jahm86/MQTT_Router_Board/README.md

# MQTT_Router_Board
Tarjeta electrónica para proyecto didáctico de router MQTT

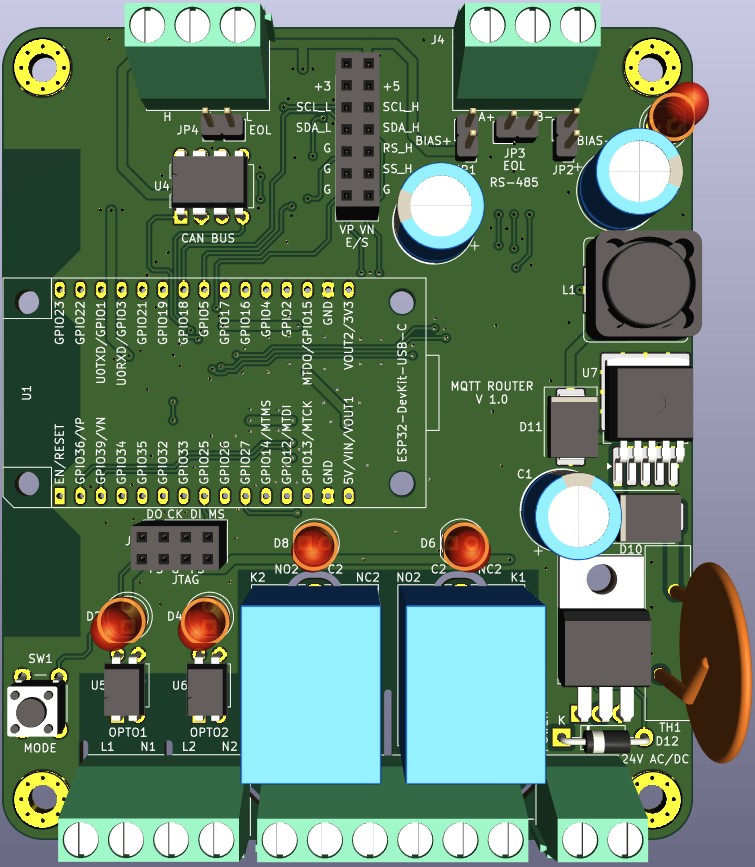
[picture p1: imagenes/MQTT_ROUTER_3D_F.jpg]
PCB de tarjeta electrónica, vista superior.

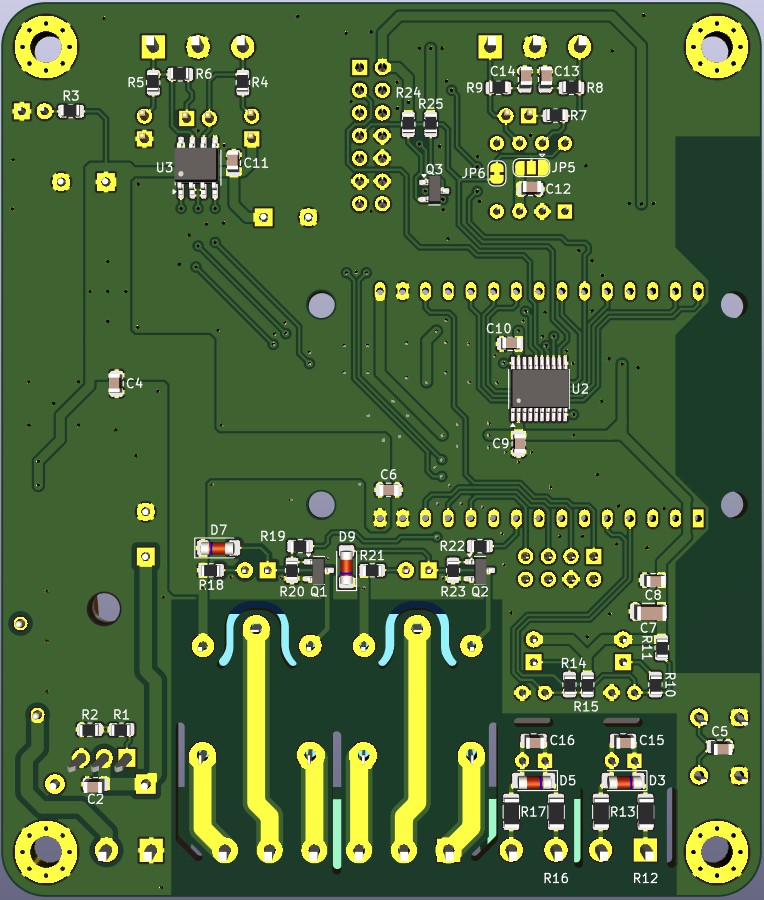
[picture p2: imagenes/MQTT_ROUTER_3D_B.jpg]
PCB de tarjeta electrónica, vista inferior.
