jahm86/MQTT_Router_Board/MQTT_ROUTER.kicad_pcb

## KiCad design MQTT_ROUTER.kicad_pcb (2026-02-03)

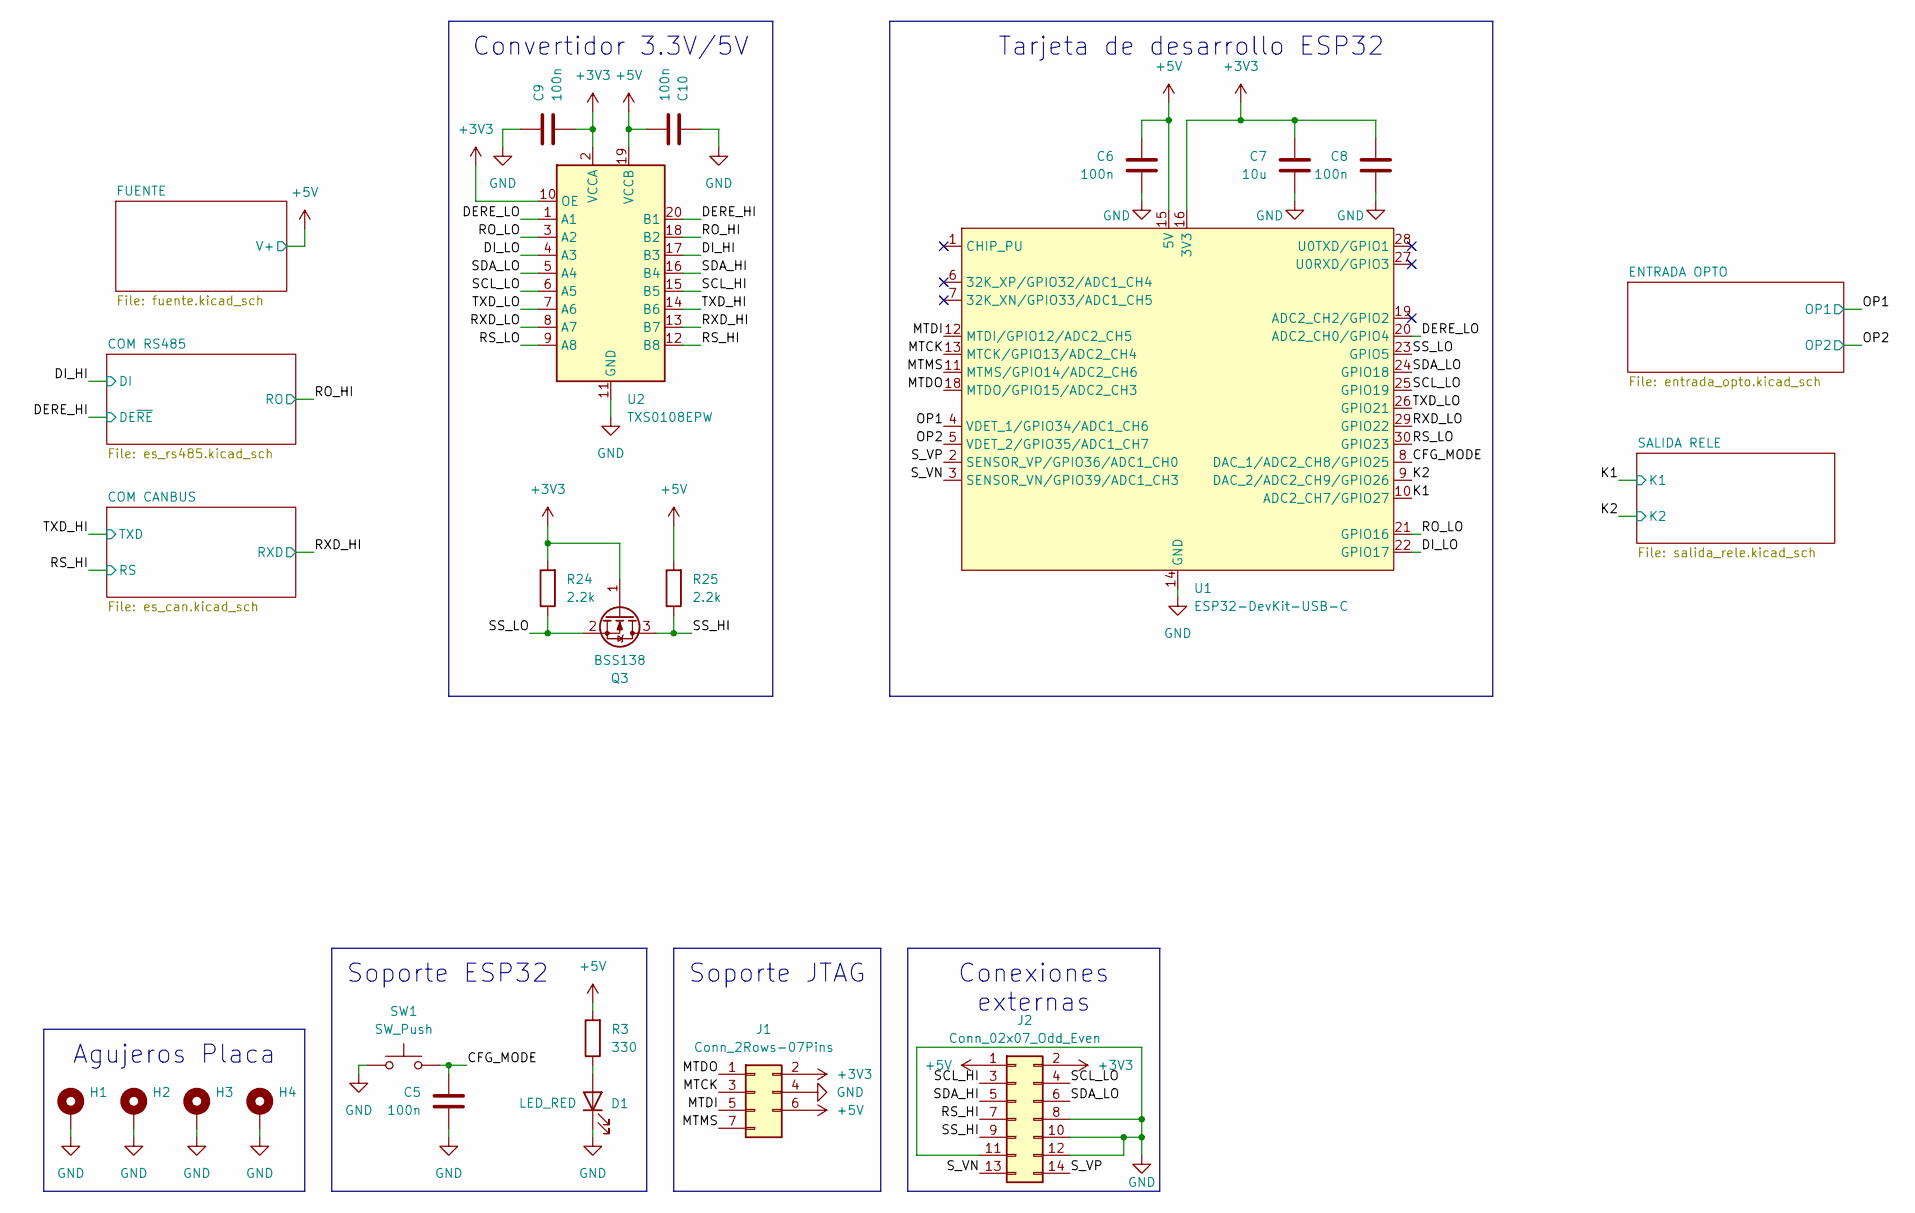
[picture p3: schematic MQTT_ROUTER.kicad_sch]

Parts:
C5, C6, C8, C9, C10: 100n; C_0805_2012Metric
C7: 10u; C_1206_3216Metric
D1: LED_RED; LED_D5.0mm
H1, H2, H3, H4: MountingHole_Pad; MountingHole_3.5mm_Pad_Via
J1: Conn_2Rows-07Pins; PinSocket_2x04_P2.54mm_Vertical
J2: Conn_02x07_Odd_Even; PinSocket_2x07_P2.54mm_Vertical
Q3: BSS138; SOT-23
R3: 330; R_0805_2012Metric
R24, R25: 2.2k; R_0805_2012Metric
SW1: SW_Push; SW_PUSH_6mm
U1: ESP32-DevKit-USB-C
U2: TXS0108EPW; TSSOP-20_4.4x6.5mm_P0.65mm

Connections:
+3V3: C7.1, C8.1, C9.2, J1.2, J2.2, Q3.1 (G), R24.2, U1.16 (3V3), U2.2 (VCCA), U2.10 (OE); also elsewhere on the board
+5V: C6.1, C10.2, J1.6, J2.1, R3.2, R25.2, U1.15 (5V), U2.19 (VCCB); also elsewhere on the board
/CFG_MODE: C5.1, SW1.2, U1.8 (DAC_1/ADC2_CH8/GPIO25)
/DERE_HI: U2.20 (B1); also elsewhere on the board
/DERE_LO: U1.20 (ADC2_CH0/GPIO4), U2.1 (A1)
/DI_HI: U2.17 (B3); also elsewhere on the board
/DI_LO: U1.22 (GPIO17), U2.4 (A3)
/K1: U1.10 (ADC2_CH7/GPIO27); also elsewhere on the board
/K2: U1.9 (DAC_2/ADC2_CH9/GPIO26); also elsewhere on the board
/MTCK: J1.3, U1.13 (MTCK/GPIO13/ADC2_CH4)
/MTDI: J1.5, U1.12 (MTDI/GPIO12/ADC2_CH5)
/MTDO: J1.1, U1.18 (MTDO/GPIO15/ADC2_CH3)
/MTMS: J1.7, U1.11 (MTMS/GPIO14/ADC2_CH6)
/OP1: U1.4 (VDET_1/GPIO34/ADC1_CH6); also elsewhere on the board
/OP2: U1.5 (VDET_2/GPIO35/ADC1_CH7); also elsewhere on the board
/RO_HI: U2.18 (B2); also elsewhere on the board
/RO_LO: U1.21 (GPIO16), U2.3 (A2)
/RS_HI: J2.7, U2.12 (B8); also elsewhere on the board
/RS_LO: U1.30 (GPIO23), U2.9 (A8)
/RXD_HI: U2.13 (B7); also elsewhere on the board
/RXD_LO: U1.29 (GPIO22), U2.8 (A7)
/SCL_HI: J2.3, U2.15 (B5)
/SCL_LO: J2.4, U1.25 (GPIO19), U2.6 (A5)
/SDA_HI: J2.5, U2.16 (B4)
/SDA_LO: J2.6, U1.24 (GPIO18), U2.5 (A4)
/SS_HI: J2.9, Q3.3 (D), R25.1
/SS_LO: Q3.2 (S), R24.1, U1.23 (GPIO5)
/S_VN: J2.13, U1.3 (SENSOR_VN/GPIO39/ADC1_CH3)
/S_VP: J2.14, U1.2 (SENSOR_VP/GPIO36/ADC1_CH0)
/TXD_HI: U2.14 (B6); also elsewhere on the board
/TXD_LO: U1.26 (GPIO21), U2.7 (A6)
GND: C5.2, C6.2, C7.2, C8.2, C9.1, C10.1, D1.1 (K), H1.1, H2.1, H3.1, H4.1, J1.4, J2.8, J2.10, J2.11, J2.12, SW1.1, U1.14 (GND), U1.17 (GND), U2.11 (GND); also elsewhere on the board
unnamed: D1.2 (A), R3.1

Notes on the sheet:
Soporte ESP32
Agujeros Placa
Convertidor 3.3V/5V
Tarjeta de desarrollo ESP32
Soporte JTAG
Conexiones externas

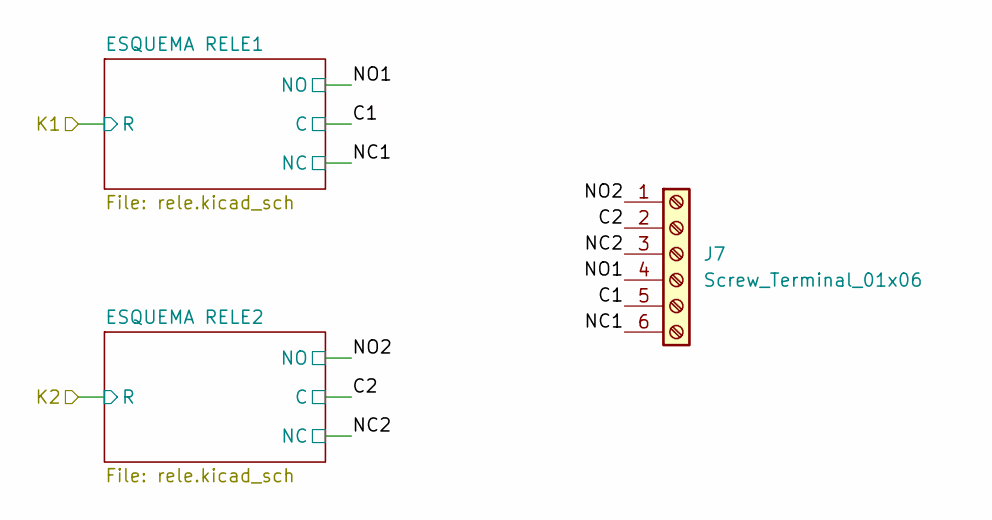
[picture p4: schematic salida_rele.kicad_sch]

Parts:
J7: Screw_Terminal_01x06; TerminalBlock_Phoenix_MKDS-1,5-6_1x06_P5.00mm_Horizontal

Connections:
/SALIDA RELE/C1: J7.5; also elsewhere on the board
/SALIDA RELE/C2: J7.2; also elsewhere on the board
/SALIDA RELE/NC1: J7.6; also elsewhere on the board
/SALIDA RELE/NC2: J7.3; also elsewhere on the board
/SALIDA RELE/NO1: J7.4; also elsewhere on the board
/SALIDA RELE/NO2: J7.1; also elsewhere on the board

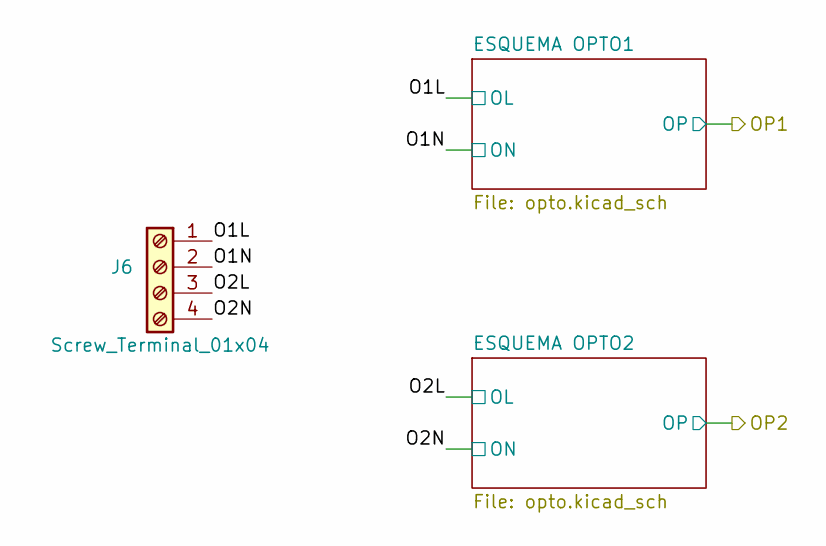
[picture p5: schematic entrada_opto.kicad_sch]

Parts:
J6: Screw_Terminal_01x04; TerminalBlock_Phoenix_MKDS-1,5-4_1x04_P5.00mm_Horizontal

Connections:
/ENTRADA OPTO/O1L: J6.1; also elsewhere on the board
/ENTRADA OPTO/O1N: J6.2; also elsewhere on the board
/ENTRADA OPTO/O2L: J6.3; also elsewhere on the board
/ENTRADA OPTO/O2N: J6.4; also elsewhere on the board

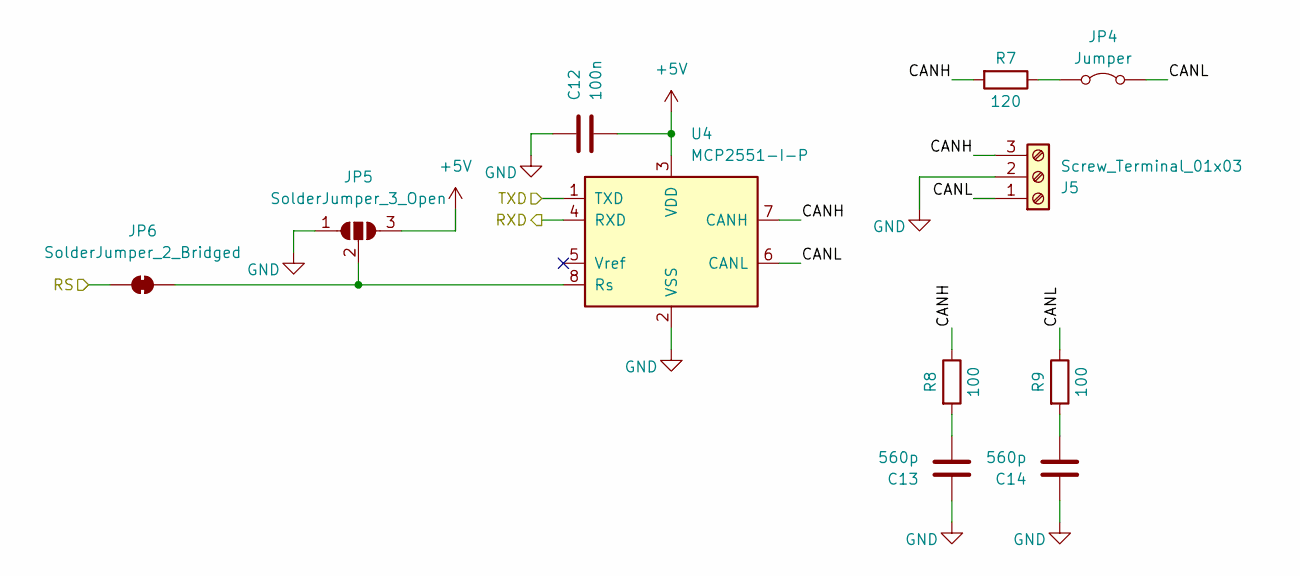
[picture p6: schematic es_can.kicad_sch]

Parts:
C12: 100n; C_0805_2012Metric
C13, C14: 560p; C_0805_2012Metric
J5: Screw_Terminal_01x03; TerminalBlock_Phoenix_MKDS-1,5-3_1x03_P5.00mm_Horizontal
JP4: Jumper; PinHeader_1x02_P2.54mm_Vertical
JP5: SolderJumper_3_Open; SolderJumper-3_P1.3mm_Open_RoundedPad1.0x1.5mm
JP6: SolderJumper_2_Bridged; SolderJumper-2_P1.3mm_Bridged_RoundedPad1.0x1.5mm
R7: 120; R_0805_2012Metric
R8, R9: 100; R_0805_2012Metric
U4: MCP2551-I-P; DIP-8_W7.62mm

Connections:
+5V: C12.2, JP5.3 (B), U4.3 (VDD); also elsewhere on the board
/COM CANBUS/CANH: J5.3, R7.2, R8.1, U4.7 (CANH)
/COM CANBUS/CANL: J5.1, JP4.2 (B), R9.1, U4.6 (CANL)
/RS_HI: JP6.1 (A); also elsewhere on the board
/RXD_HI: U4.4 (RXD); also elsewhere on the board
/TXD_HI: U4.1 (TXD); also elsewhere on the board
GND: C12.1, C13.1, C14.1, J5.2, JP5.1 (A), U4.2 (VSS); also elsewhere on the board
unnamed: C13.2, R8.2
unnamed: C14.2, R9.2
unnamed: JP4.1 (A), R7.1
unnamed: JP5.2 (C), JP6.2 (B), U4.8 (Rs)

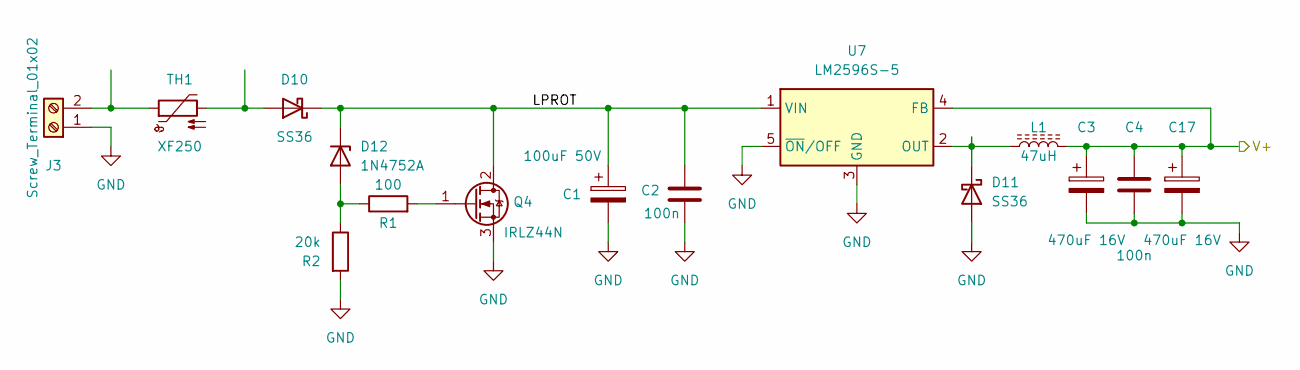
[picture p7: schematic fuente.kicad_sch]

Parts:
C1: 100uF 50V; CP_Radial_D10.0mm_P5.00mm
C2, C4: 100n; C_0805_2012Metric
C3, C17: 470uF 16V; CP_Radial_D10.0mm_P5.00mm
D10, D11: SS36; D_SMC
D12: 1N4752A; D_DO-41_SOD81_P10.16mm_Horizontal
J3: Screw_Terminal_01x02; TerminalBlock_Phoenix_MKDS-1,5-2_1x02_P5.00mm_Horizontal
L1: 47uH; L_Bourns_SRR1260
Q4: IRLZ44N; TO-220-3_Horizontal_TabDown
R1: 100; R_0805_2012Metric
R2: 20k; R_0805_2012Metric
TH1: XF250; Fuse_BelFuse_0ZRE0125FF_L21.2mm_W5.3mm
U7: LM2596S-5; TO-263-5_TabPin3

Connections:
+5V: C3.1, C4.1, C17.1, L1.2, U7.4 (FB); also elsewhere on the board
/FUENTE/LPROT: C1.1, C2.1, D10.1 (K), D12.1 (K), Q4.2 (D), U7.1 (VIN)
GND: C1.2, C2.2, C3.2, C4.2, C17.2, D11.2 (A), J3.1, Q4.3 (S), R2.2, U7.3 (GND), U7.5 (~ON/OFF); also elsewhere on the board
unnamed: D10.2 (A), TH1.2
unnamed: D11.1 (K), L1.1, U7.2 (OUT)
unnamed: D12.2 (A), R1.1, R2.1
unnamed: J3.2, TH1.1
unnamed: Q4.1 (G), R1.2

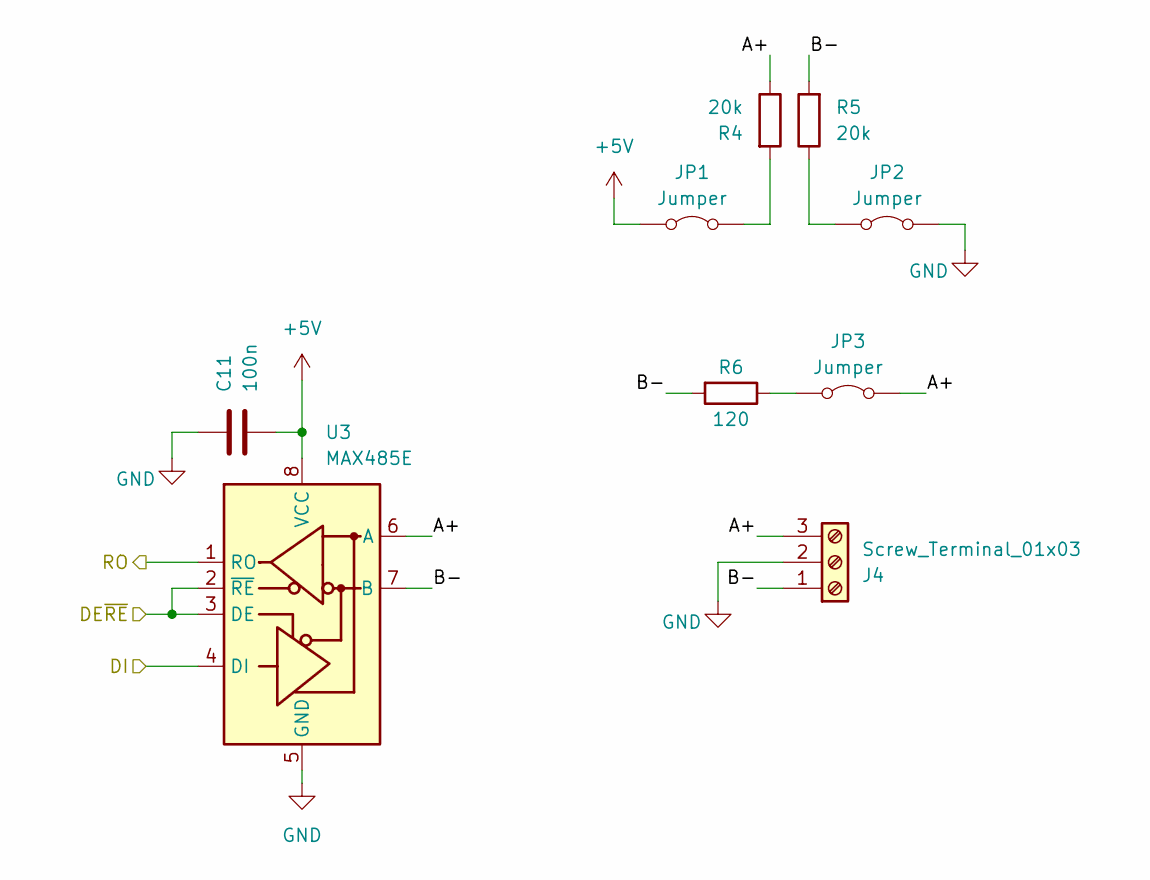
[picture p8: schematic es_rs485.kicad_sch]

Parts:
C11: 100n; C_0805_2012Metric
J4: Screw_Terminal_01x03; TerminalBlock_Phoenix_MKDS-1,5-3_1x03_P5.00mm_Horizontal
JP1, JP2, JP3: Jumper; PinHeader_1x02_P2.54mm_Vertical
R4, R5: 20k; R_0805_2012Metric
R6: 120; R_0805_2012Metric
U3: MAX485E; SOIC-8_3.9x4.9mm_P1.27mm

Connections:
+5V: C11.2, JP1.1 (A), U3.8 (VCC); also elsewhere on the board
/COM RS485/A+: J4.3, JP3.2 (B), R4.1, U3.6 (A)
/COM RS485/B-: J4.1, R5.2, R6.2, U3.7 (B)
/DERE_HI: U3.2 (~RE), U3.3 (DE); also elsewhere on the board
/DI_HI: U3.4 (DI); also elsewhere on the board
/RO_HI: U3.1 (RO); also elsewhere on the board
GND: C11.1, J4.2, JP2.1 (A), U3.5 (GND); also elsewhere on the board
unnamed: JP1.2 (B), R4.2
unnamed: JP2.2 (B), R5.1
unnamed: JP3.1 (A), R6.1

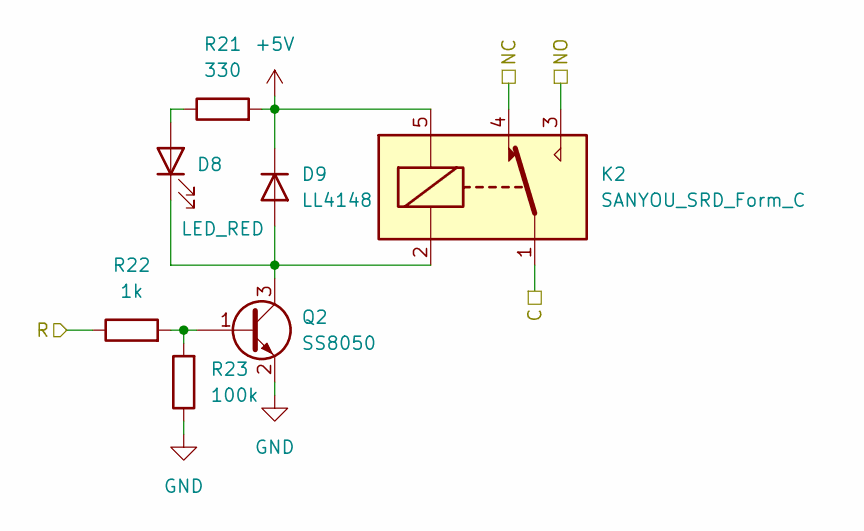
[picture p9: schematic rele.kicad_sch]

Parts:
D8: LED_RED; LED_D5.0mm
D9: LL4148; D_MiniMELF
K2: SANYOU_SRD_Form_C; Relay_SPDT_SANYOU_SRD_Series_Form_C
Q2: SS8050; SOT-23
R21: 330; R_0805_2012Metric
R22: 1k; R_0805_2012Metric
R23: 100k; R_0805_2012Metric

Connections:
+5V: D9.1 (K), K2.5, R21.2; also elsewhere on the board
/K2: R22.1; also elsewhere on the board
/SALIDA RELE/C2: K2.1; also elsewhere on the board
/SALIDA RELE/NC2: K2.4; also elsewhere on the board
/SALIDA RELE/NO2: K2.3; also elsewhere on the board
GND: Q2.2 (E), R23.1; also elsewhere on the board
unnamed: D8.2 (A), R21.1
unnamed: D8.1 (K), D9.2 (A), K2.2, Q2.3 (C)
unnamed: Q2.1 (B), R22.2, R23.2

Parts of its further copies:
D6: LED_RED; LED_D5.0mm
D7: LL4148; D_MiniMELF
K1: SANYOU_SRD_Form_C; Relay_SPDT_SANYOU_SRD_Series_Form_C
Q1: SS8050; SOT-23
R18: 330; R_0805_2012Metric
R19: 1k; R_0805_2012Metric
R20: 100k; R_0805_2012Metric

Connections of its further copies:
+5V: D7.1 (K), K1.5, R18.2; also elsewhere on the board
/K1: R19.1; also elsewhere on the board
/SALIDA RELE/C1: K1.1; also elsewhere on the board
/SALIDA RELE/NC1: K1.4; also elsewhere on the board
/SALIDA RELE/NO1: K1.3; also elsewhere on the board
GND: Q1.2 (E), R20.1; also elsewhere on the board
unnamed: D6.2 (A), R18.1
unnamed: D6.1 (K), D7.2 (A), K1.2, Q1.3 (C)
unnamed: Q1.1 (B), R19.2, R20.2

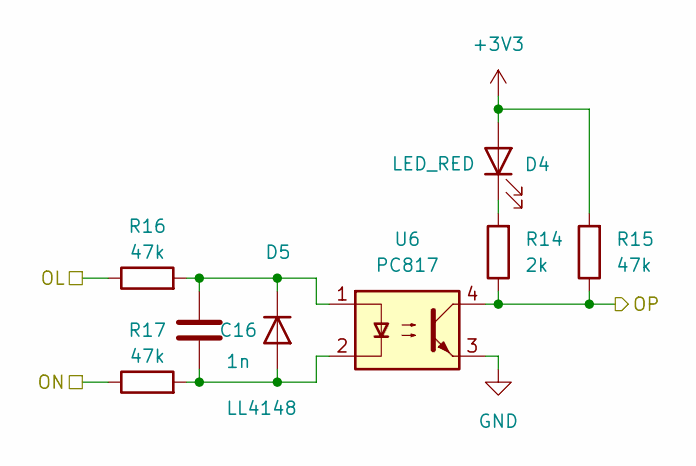
[picture p10: schematic opto.kicad_sch]

Parts:
C16: 1n; C_0805_2012Metric
D4: LED_RED; LED_D5.0mm
D5: LL4148; D_MiniMELF
R14: 2k; R_0805_2012Metric
R15: 47k; R_0805_2012Metric
R16, R17: 47k; R_1206_3216Metric
U6: PC817; DIP-4_W7.62mm

Connections:
+3V3: D4.2 (A), R15.2; also elsewhere on the board
/ENTRADA OPTO/O2L: R16.1; also elsewhere on the board
/ENTRADA OPTO/O2N: R17.1; also elsewhere on the board
/OP2: R14.1, R15.1, U6.4; also elsewhere on the board
GND: U6.3; also elsewhere on the board
unnamed: D4.1 (K), R14.2
unnamed: C16.2, D5.2 (A), R17.2, U6.2
unnamed: C16.1, D5.1 (K), R16.2, U6.1

Parts of its further copies:
C15: 1n; C_0805_2012Metric
D2: LED_RED; LED_D5.0mm
D3: LL4148; D_MiniMELF
R10: 2k; R_0805_2012Metric
R11: 47k; R_0805_2012Metric
R12, R13: 47k; R_1206_3216Metric
U5: PC817; DIP-4_W7.62mm

Connections of its further copies:
+3V3: D2.2 (A), R11.2; also elsewhere on the board
/ENTRADA OPTO/O1L: R12.1; also elsewhere on the board
/ENTRADA OPTO/O1N: R13.1; also elsewhere on the board
/OP1: R10.1, R11.1, U5.4; also elsewhere on the board
GND: U5.3; also elsewhere on the board
unnamed: D2.1 (K), R10.2
unnamed: C15.2, D3.2 (A), R13.2, U5.2
unnamed: C15.1, D3.1 (K), R12.2, U5.1

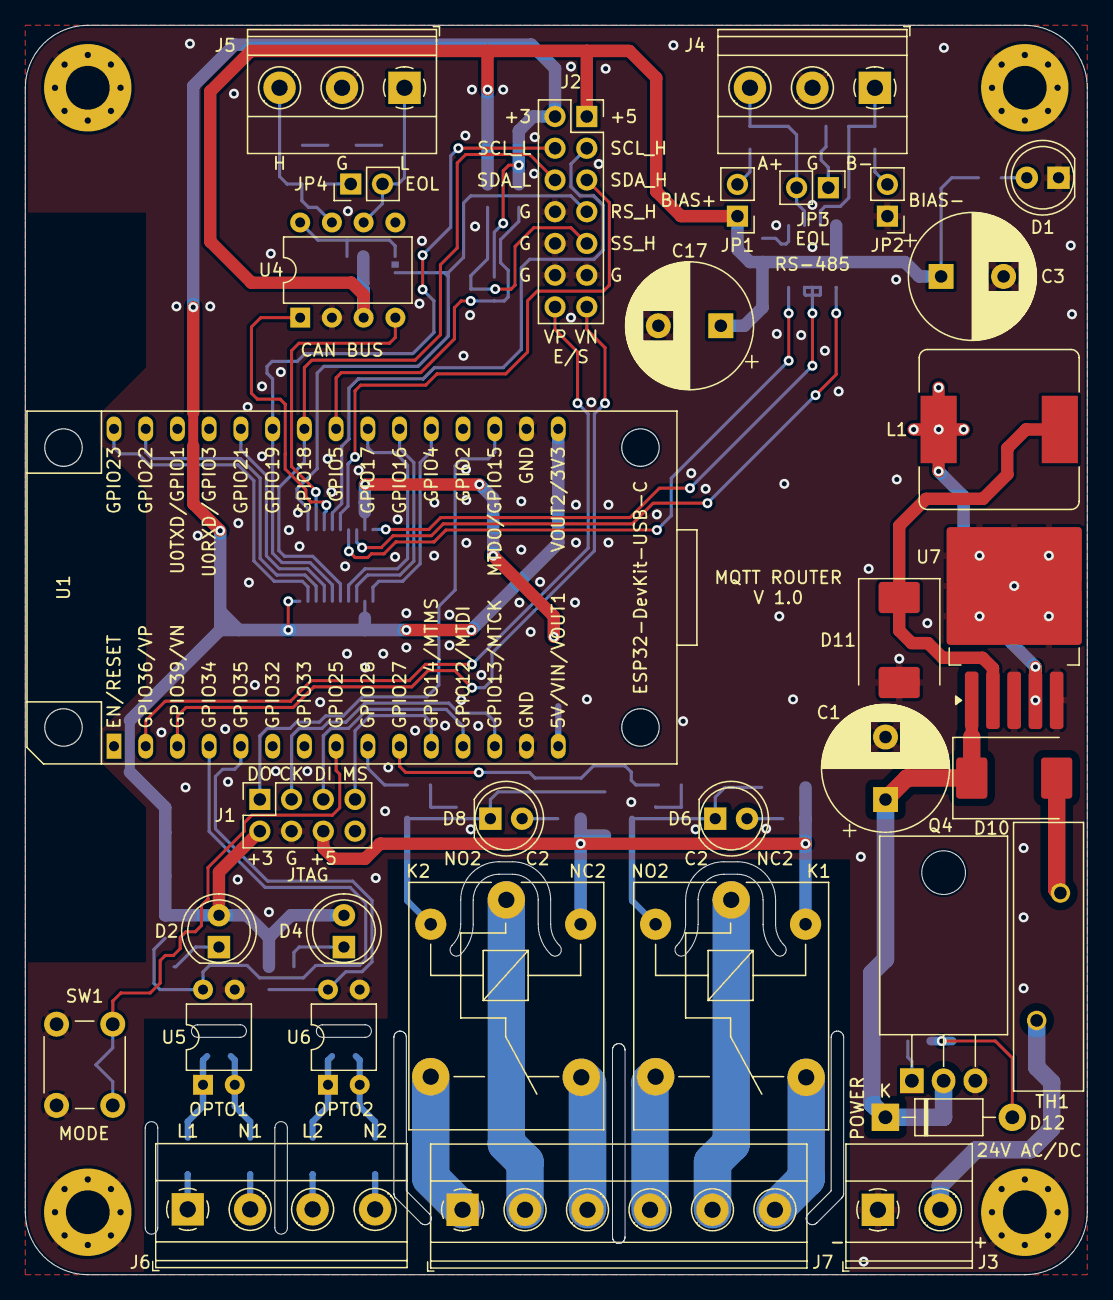
[picture p11: board MQTT_ROUTER.kicad_pcb from above]

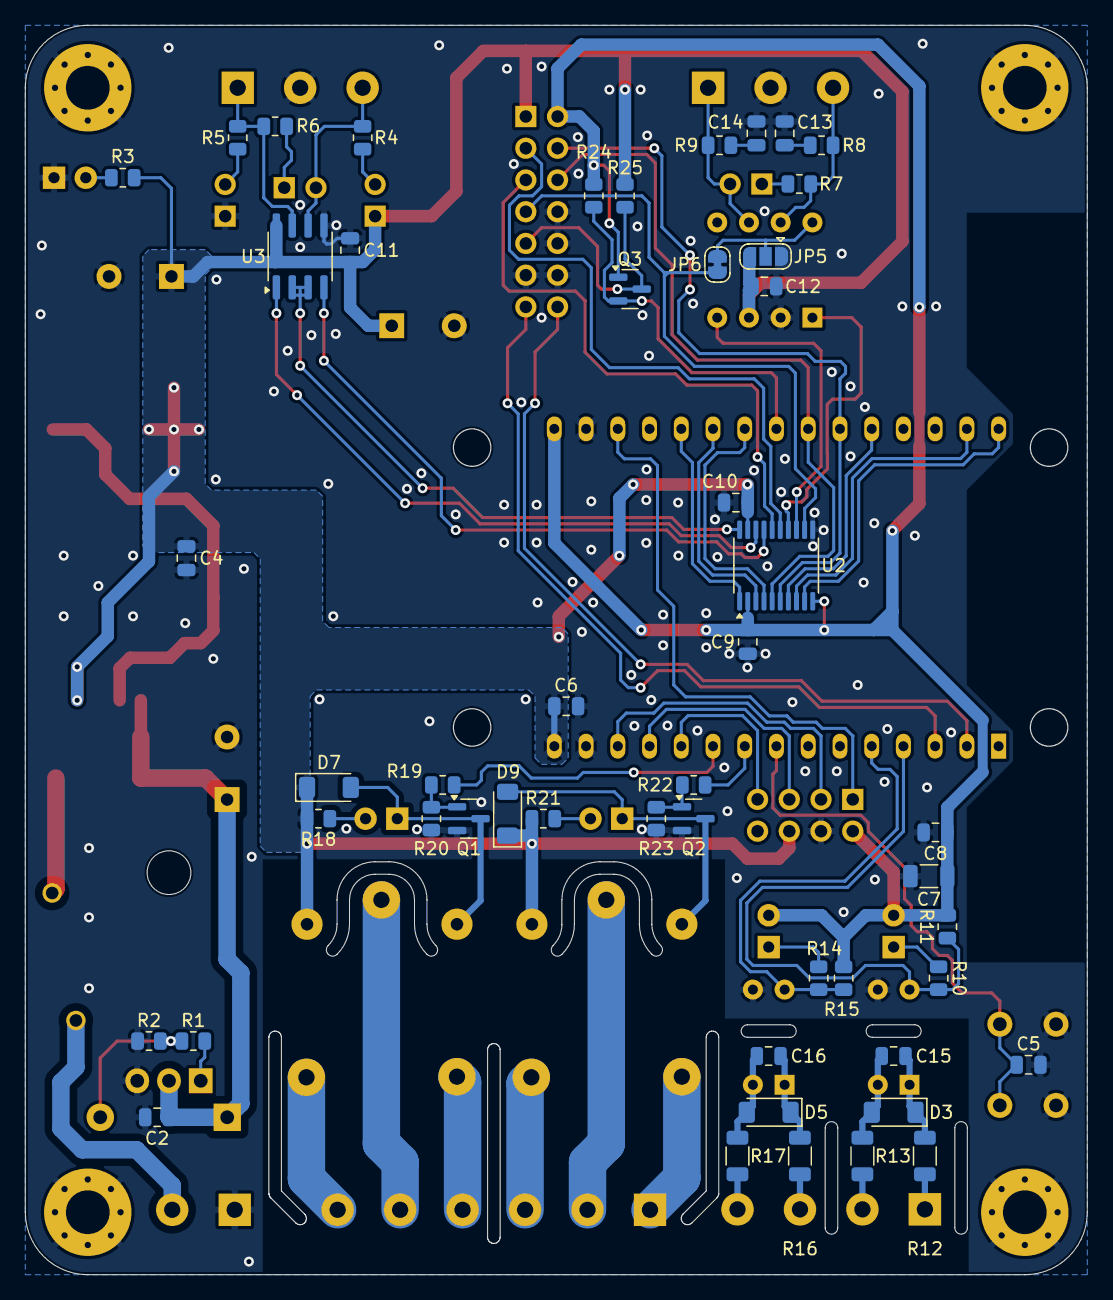
[picture p12: board MQTT_ROUTER.kicad_pcb from below]

Board: 2 copper layers, 85.0 x 100.0 mm, 87 parts (50 on the bottom side), 72 nets.
