jahm86/MQTT_Router_Board/(commit log)

2025-10-14 Primera encomienda
    [MQTT_ROUTER.kicad_pcb, MQTT_ROUTER.kicad_sch, entrada_opto.kicad_sch, es_can.kicad_sch, es_rs485.kicad_sch, fuente.kicad_sch, opto.kicad_sch, rele.kicad_sch]
2025-10-17 Reparar ubicación de serigrafías y errores de DRC. Mejorar pistas de 5V y 3V.
    [MQTT_ROUTER.kicad_pcb]
2025-10-26 Agregar nueva tarjeta ESP32 USB-C, con repo creado recientemente
2025-10-28 Actualizar componentes, pistas e imágenes
    [MQTT_ROUTER.kicad_pcb, MQTT_ROUTER.kicad_sch]
2026-01-02 Agregar protección de sobre tensión/tensión inversa
    [fuente.kicad_sch]
2026-01-02 Agregar protección de sobre tensión/tensión inversa (2)
    [fuente.kicad_sch]
2026-01-02 Agregar protección de sobre tensión/tensión inversa (3)
    [fuente.kicad_sch]
2026-01-02 Agregar protección de sobre tensión/tensión inversa (4)
    [fuente.kicad_sch]
2026-01-02 Cambiar agujeros de placa, invertir terminales de fuente
    [MQTT_ROUTER.kicad_sch, fuente.kicad_sch]
2026-01-03 Actualizar PCB
    [MQTT_ROUTER.kicad_pcb]
2026-01-03 Actualizar zener a 1N4752A (33V)
    [MQTT_ROUTER.kicad_pcb, fuente.kicad_sch]
2026-01-07 Ajustar grosor de pistas S_VP/S_VN
    [MQTT_ROUTER.kicad_pcb]
2026-01-07 Aumentar mínimo de vía a 0.8/0.4
    [MQTT_ROUTER.kicad_pcb]
2026-01-07 Aumentar mínimo de vía a 0.8/0.4 (2)
    [MQTT_ROUTER.kicad_pcb]
2026-01-11 Actualizar PCB (2)
    [MQTT_ROUTER.kicad_pcb]
2026-01-11 Actualizar PCB (3)
    [MQTT_ROUTER.kicad_pcb]
2026-01-11 Aumentar distancia entre soldermask y pad en PCB
    [MQTT_ROUTER.kicad_pcb]
2026-01-13 Corregir distancia entre soldermask y pad en PCB
    [MQTT_ROUTER.kicad_pcb]
2026-02-03 Agregar más ranuras de aislamiento
    [MQTT_ROUTER.kicad_pcb]
